OSU-HEP-HDL/Serial-Power-Supply/Power Supply - PCB Designs/DCDC_parts_names_map.xlsx

Part name |  | Value
Demo board | Actual design | Demo board | Actual design
CIN1 | C1 & C2 | 47 uF | 47 uF
CIN2 | C3 | 2.2 uF | 2.2 uF
CIN 3 | C4 | 2.2 uF | 2.2 uF
R1 | - | 1 M | -
C1 | C5 | 0.47 uF | 0.47 uF
R3 | R3 | 82.5k | 100k
C3 | C7 | 1500 pF | 1500 pF
R15 | R6 | 5M1 | 5M1
R14 | R7 | optional | 0.00 ohm
C12 | C15 | optional | 10 nF
R9 | R11 | 143 k | 100k
R8 | R12 | 16.2 k | 10k
R7 | R9 | 20 k | 30.9 k
C7 | C17 | 2.2 nF | 2.2 nF
C6 | C16 | 100 pF | 100 pF
R18 | R8 | 100 k | 100 k
R10 | R10 | 49.9 k | 118 k
R2 | R1 | 0.00 ohm | 0.00 ohm
C2 | C6 | 0.1 uF | 0.1 uF
R4 | R2 | 0.00 ohm | 0.00 ohm
Q1 | Q1 |  | Si7470DP
Q4 | Q2 |  | Si7470DP
R5 | R4 | 0.00 ohm | 0.00 ohm
D1 | D1 | BAS521 | BAS521
C5 | C14 | 1 uF | 1 uF
D3 | D3 | 1N4148WS-7 | 1N4148WS-7-F
D8 | D4 | B210, optional | B160-13-F
C13 | C18 | optional | CAP1206
R15 | R6 | 0.00 ohm | 0.00 ohm
Q2 | Q3 |  | Si7470DP
Q5 | Q4 |  | Si7470DP
C4 | C10 | 470 pF | 470 pF
D2 | D2 | B160-13-F | B160-13-F
L1 | L1 | 15 uH | 15 uH
COUT1 | C9 | 68 uF | 68 uF
COUT2 | C8 | 68 uF | 68 uF
COUT3 | C11 | 22 uF | 22 uF
- | C12 | - | 22 uF
COUT4 | C13 | 1 uF | 1 uF
