OSU-HEP-HDL/Serial-Power-Supply/References/1073A/1073acus.xls

Qty | Reference | Part Description | Manufacturer / Part # | Kit Qty | Pkg Qty | Bal. | Parts/Purch.
 | REQUIRED CIRCUIT COMPONENTS:
1 | CIN1 | CAP., SMT Aluminum, 47uF, 63V | SANYO, 63CE47FS
2 | CIN2,CIN3 | CAP., X7R, 2.2uF, 100V, 10%, 1812 | TDK, C4532X7R2A225K
2 | COUT1,COUT2 | CAP., POSCAP, 68uF, 16V, 20%, | SANYO, 16TQC68M
1 | COUT3 | CAP., X5R, 22uF,16V, 10%, 1210 | AVX, 1210YD226KAT
1 | C1 | CAP., X5R, 0.47uF, 100V, 10%, 1206 | TDK, C3216X5R2A474KAT
1 | C2 | CAP., X5R, 0.1uF, 16V, 10%, 0402 | AVX, 0402YD104KAT
1 | C3 | CAP., X7R, 1500pF, 50V, 10%, 0402 | AVX, 04025C152KAT
1 | C4 | CAP., X5R, 470pF, 50V, 10%,1206 | AVX, 12065C1470KAT
2 | C5,COUT4 | CAP., X5R, 1uF, 16V, 10%, 0603 | TDK, C1608X5R1C105K
1 | C6 | CAP., COG, 100pF, 50V, 10%, 0402 | TDK, C1005COG1H101J
1 | C7 | CAP., X7R, 2200pF, 50V, 10%, 0402 | AVX, 04025C222KAT
1 | D1 | HIGH VOLTAGE SWITCHING DIODE, SOD-523 | PHILPS, BAS521
1 | D3 | HIGH VOLTAGE SWITCHING DIODE, SOD-323 | DIODES INC, 1N4148WS-7-F
1 | D2 | SMT SCHOTTKY BARRIER RECTIFIER, SMB | DIODES INC, B160-13-F
1 | L1 | INDUCTOR, 15uH | Wurth Elektronik S06100021
 | L1 - ALTERNATE | INDUCTOR, 15uH | VISHAY, IHLP5050EZEB150M01
2 | Q1,Q2 | N-Channel TrenchMOS Logic Level FET, 60V | VISHAY, Si7370DP-T1-E3
1 | R1 | RES., CHIP, 1M, 1/16W, 1% ,0402 | AAC, CR05-1004FM
4 | R2,R4,R5,R15 | RES., CHIP, 0, 1/16W, 0402 | AAC, CJ05-000M
1 | R3 | RES., CHIP, 82.5K, 1/16W, 1% ,0402 | AAC, CR05-8252FM
1 | R7 | RES., CHIP, 20K, 1/16W, 1% ,0402 | AAC, CR05-2002FM
1 | R6 | RES., CHIP, 5.1M, 1/16W, 5% ,0402 | Panasonic, ERJ2GEJ515X
1 | R8 | RES., CHIP, 16.2K, 1/16W, 1% ,0402 | AAC, CR05-1622FM
1 | R9 | RES., CHIP, 143K, 1/16W, 1% ,0402 | AAC, CR05-1433FM
1 | R10 | RES., CHIP, 49.9K, 1/16W, 1% ,0402 | AAC, CR05-4992FM
1 | R11 | RES., CHIP, 0.01, 1W, 1% ,0815 | THIN FILM TECH,RL3720WT-R010-F
1 | R18 | RES., CHIP, 100K, 1/16W, 1% , 0402 | AAC, CR05-1003FM
1 | U1 | I.C, LT3845EFE#PBF, TSSOP(4.4MM) 16PIN | LINEAR TECH., LT3845EFE#PBF
 | ADDITIONAL DEMO BOARD CIRCUIT COMPONENTS:
6 | C8-C13(OPT) | CAP., 0402
2 | D4,D5(OPT) | DUAL SMT SWITCHING DIODE, SOT-23 | DIODES INC, BAV99-7-F
1 | D8(OPT) | SMT SCHOTTKY BARRIER RECTIFIER, SMA
1 | Q3(OPT) | Complementary Low-Threshold MOSFET Pair, SC-70 | VISHAY, Si1555DL-T1-E3
2 | Q4,Q5(OPT) | N-Channel 60V, MOSFET, | VISHAY, Si7370DP-T1-E3
3 | R12-R14(OPT) | RES., 0402
 | HARDWARE-FOR DEMO BOARD ONLY:
4 | E1-E4 | JACK, BANANA | KEYSTONE 575-4
5 | E5,E7-E10 | TESTPOINT, TURRET, .095" | MILL-MAX, 2501-2-00-80-00-00-07-0
4 | STAND-OFF | STAND-OFF, NYLON 0.50" tall | KEYSTONE, 8833(SNAP ON)
1 | JP1 | 2MM Single Row Header, 3 PIN | SAMTEC, TMM-103-02-L-S
1 | JP2 | 2MM Double Row Header 2x3 | SAMTEC, TMM-103-02-L-D
2 | JP1,JP2 | SHUNT, | SAMTEC, 2SN-BK-G
