OSU-HEP-HDL/Serial-Power-Supply/Simulations/3845A.asc

C1: cap; .1µ
C2: cap; 32000p; Rser=5k Cpar=100p
C3: cap; 1500p
C4: cap; 100µ; Rser=5m
C5: cap; 1µ
C6: cap; 10p
C7: cap; 470p
C8: cap; 100p
D1: schottky; MBRS140
D2: schottky; MBRS1100
D3: diode; 1N4148
D4: schottky; MBRS1100
L1: ind; 6.8µ; Rpar=2K
Q1: nmos; Si7370DP
Q2: nmos; Si7370DP
R1: res; 1Meg
R2: res; 10k
R3: res; 6m
R4: res; 118K
R5: res; 100K
R6: res; 10K
R7: res; 82.5K
Rload: res; 4
U1: LT3845A
V1: voltage; 55; Cpar=100u
V2: voltage; 1.2; Rser=10k
Named nets: 0, OUT, IN
.tran 2m startup
