OSU-HEP-HDL/Serial-Power-Supply/Simulations/RC Filter.asc

C1: cap; 100n
C2: cap; 100n
R1: res; 2.5K
R2: res; 2.5K
V1: voltage; PULSE(0 1 0 10n 10n 10u 100u 0)
Named nets: 0
.tran 0 10m 0 0.1u
