OSU-HEP-HDL/Serial-Power-Supply/(list of files, drawings)

Other design files:
Power Supply - PCB Designs/Project Outputs for Serial Power Supply/Sources/Controller.SchDoc
Power Supply - PCB Designs/Project Outputs for Serial Power Supply/Sources/Current Regulator.SchDoc
Power Supply - PCB Designs/Project Outputs for Serial Power Supply/Sources/DC-DC Converter.SchDoc
Power Supply - PCB Designs/Project Outputs for Serial Power Supply/Sources/Mechanical.SchDoc
Power Supply - PCB Designs/Project Outputs for Serial Power Supply/Sources/Serial Power Supply - Main.SchDoc
Power Supply - PCB Designs/Project Outputs for Serial Power Supply/Sources/Serial Power Supply.PcbDoc
Power Supply - PCB Designs/Project Outputs for Serial Power Supply/Sources/Serial Power Supply.PrjPcb
References/1073A/DC1073A.DSN
References/1073A/DC1073A.pcb
