OSU-HEP-HDL/Serial-Power-Supply/(commit log)

2018-09-27 Project Setup
    [Serial Power Supply - Main.SchDoc, Serial Power Supply.PcbDoc, Serial Power Supply.PrjPcb]
2018-10-18 Prototype Finished
    [Serial Power Supply.PrjPcb]
2018-10-18 Design Finished
    [Controller.SchDoc, Current Regulator.SchDoc, DC-DC Converter.SchDoc, Mechanical.SchDoc, Serial Power Supply - Main.SchDoc, Serial Power Supply.PcbDoc]
2018-10-18 Design Finished
    Ready for output file generation
    [1073acus.xls, DC1073A.DSN, DC1073A.pcb, DCDC_parts_names_map.xlsx, Resistor Caclulations.xlsx]
2019-12-02 Released Design
    [Controller.SchDoc, Current Regulator.SchDoc, DC-DC Converter.SchDoc, Mechanical.SchDoc, Serial Power Supply - Main.SchDoc, Serial Power Supply.PcbDoc, Serial Power Supply.PrjPcb]
